flatlinerc/workshop_my-first-robot/GRABCAD/tt-dc-gear-motor-1.snapshot.3/Robot Car Gear Motor/Assembly.png

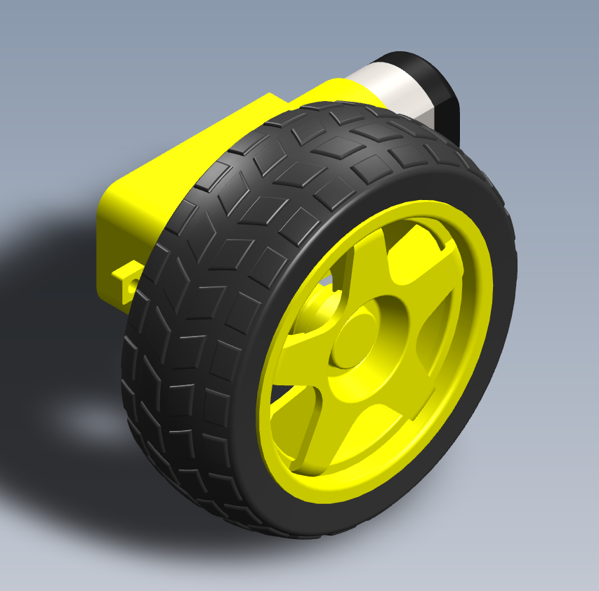
GRABCAD/tt-dc-gear-motor-1.snapshot.3/Robot Car Gear Motor/Assembly.png
