flatlinerc/workshop_my-first-robot/GRABCAD/module-vl53l0x-tof-distance-measurement-1.snapshot.7/vl53l0X_bottom_b.png

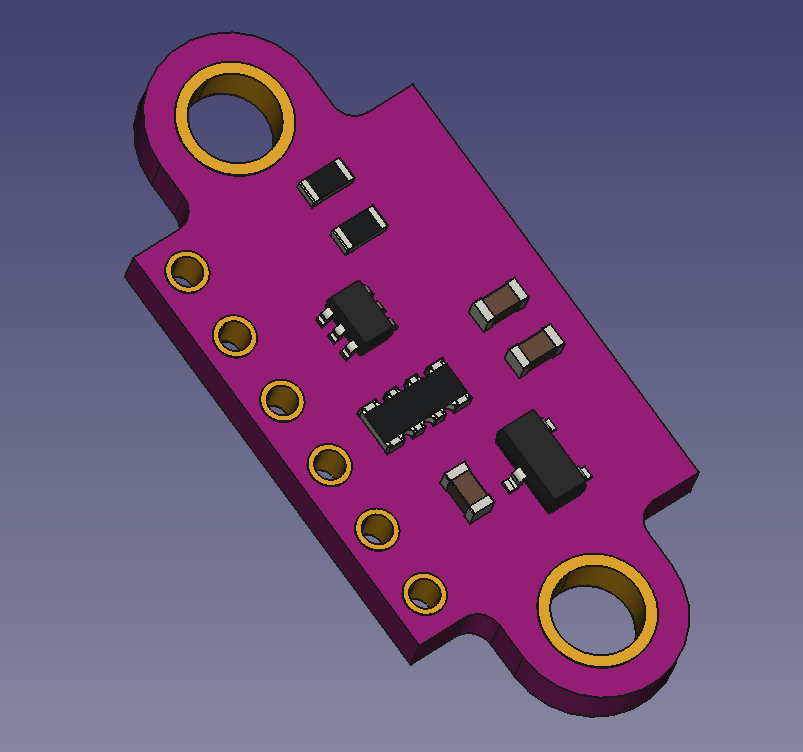
GRABCAD/module-vl53l0x-tof-distance-measurement-1.snapshot.7/vl53l0X_bottom_b.png
