flatlinerc/workshop_my-first-robot/README.md

# My First Robot

My First Robot is a workshop to give people an introduction into 'robotics'.  It consists of off the shelf parts, a 3d printed chassis, a software suite, teachers guide, and associated files.

This is designed to be expedient and made cheaply and quickly so that students can get an idea of how things can be done with 3d printers and the ready supply of hobbyist ready components.

BOM:

- ESP32 microcontroller
- VL53L0X ToF distance sensor
- DRV8833 dual motor driver breakout board
- 3d printed chassis
- M3 screws of varying sizes
- Dupont style jumper wires

# Links
- [ESP32 Pin Reference from FluidNC Wiki](http://wiki.fluidnc.com/en/hardware/esp32_pin_reference)
- [Fork of VL53L0X component](https://github.com/flatlinerc/ESP32_VL53L0X)
- [Firmware](https://github.com/flatlinerc/mfr-firmware)
- [CardCode](https://github.com/flatlinerc/cardcode)
