flatlinerc/workshop_my-first-robot/GRABCAD/ball-caster-1.snapshot.2/Renderings/Flange-Mount Ball Transfer.JPG

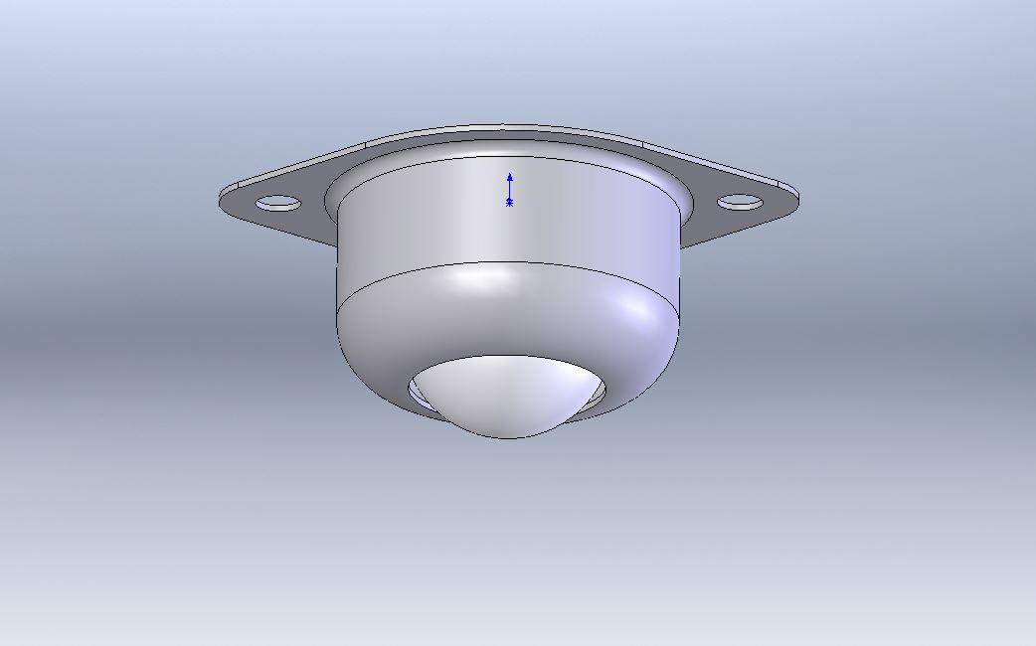
GRABCAD/ball-caster-1.snapshot.2/Renderings/Flange-Mount Ball Transfer.JPG
