flatlinerc/workshop_my-first-robot/GRABCAD/distance_sensor-1.snapshot.12/IMG/img_sensor1.JPG

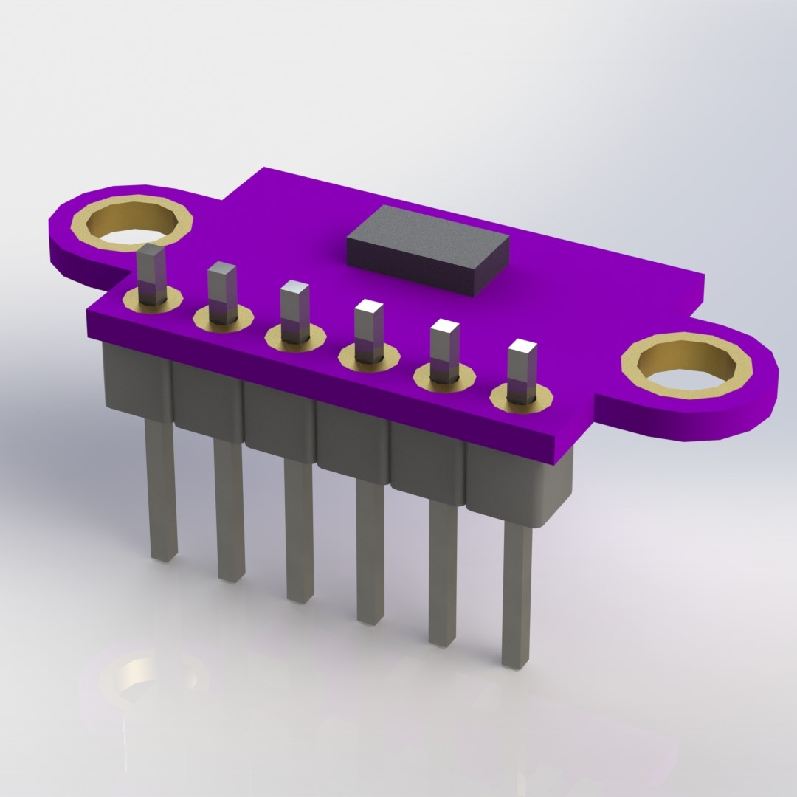
GRABCAD/distance_sensor-1.snapshot.12/IMG/img_sensor1.JPG
