flatlinerc/workshop_my-first-robot/GRABCAD/drv8833-carrier-breakout-board-1.snapshot.2/DRV8833.png

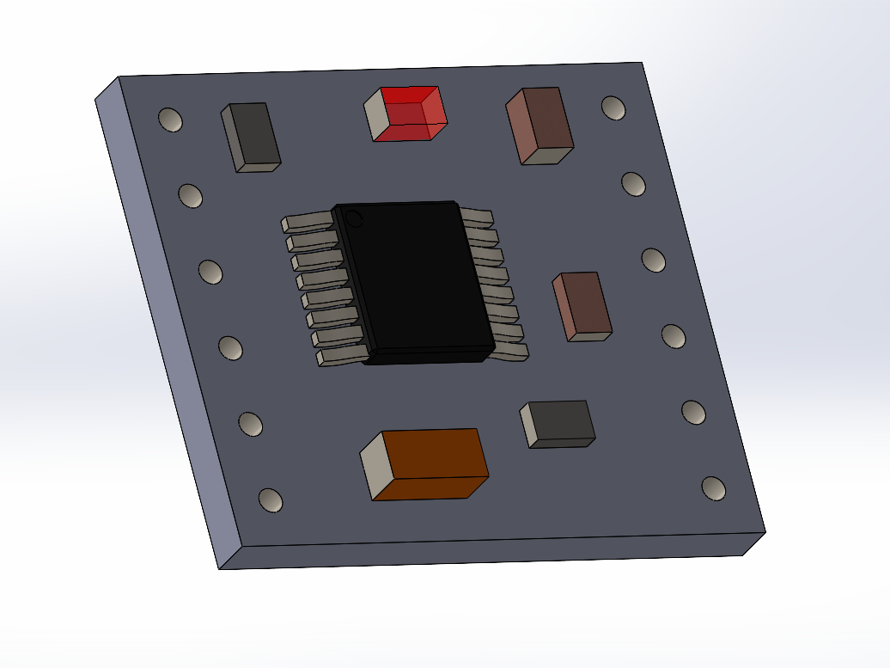
GRABCAD/drv8833-carrier-breakout-board-1.snapshot.2/DRV8833.png
