flatlinerc/workshop_my-first-robot/GRABCAD/drv8833-doble-puente-h-dual-h-bridge-motor-driver-1.snapshot.3/Modulo DRV8833/Renders/Modulo_DRV8833_A.jpg

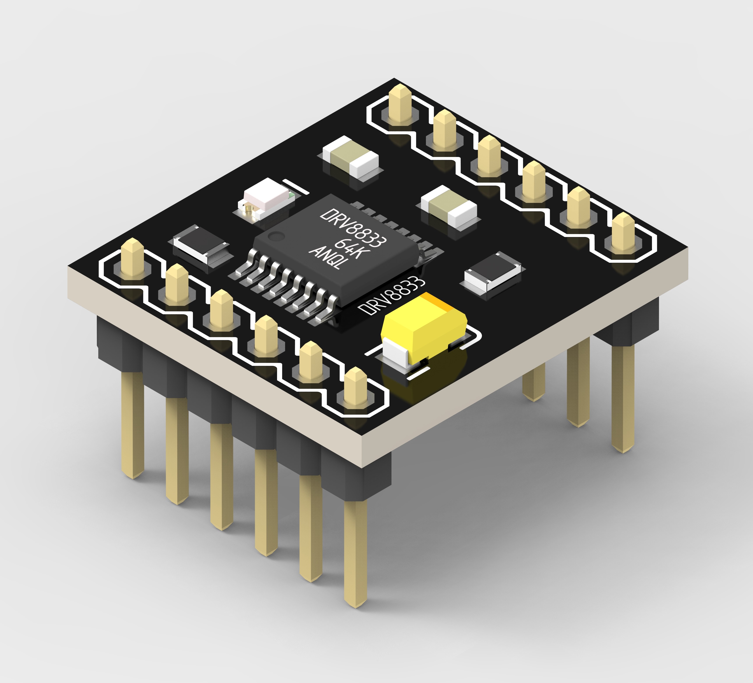
GRABCAD/drv8833-doble-puente-h-dual-h-bridge-motor-driver-1.snapshot.3/Modulo DRV8833/Renders/Modulo_DRV8833_A.jpg
