flatlinerc/workshop_my-first-robot/GRABCAD/drv8833-motor-driver-1.snapshot.2/DRV8833.JPG

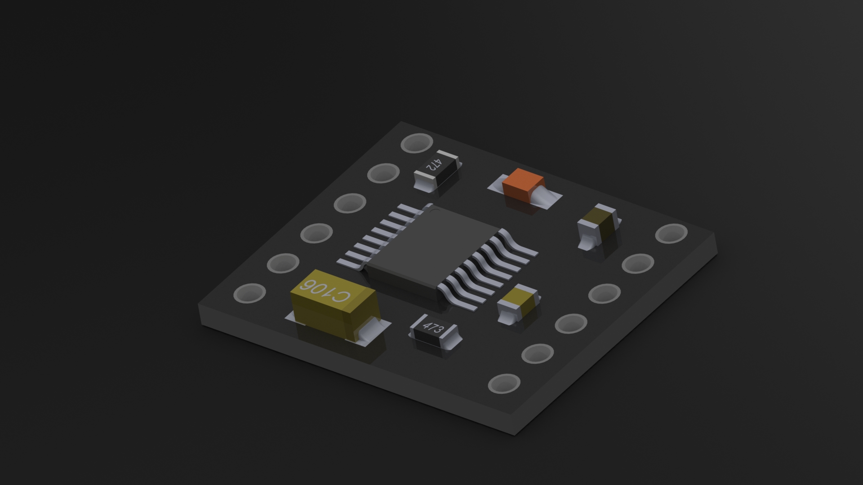
GRABCAD/drv8833-motor-driver-1.snapshot.2/DRV8833.JPG
