flatlinerc/workshop_my-first-robot/GRABCAD/esp32-dev-kit-v1-2.snapshot.2/34497376-0b36-4545-9b0b-ad642837c764.png

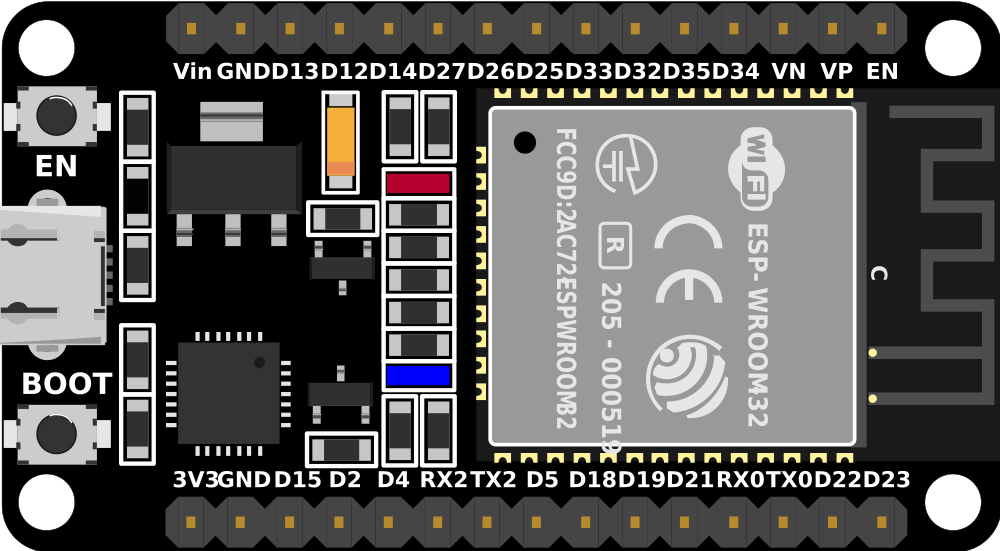
GRABCAD/esp32-dev-kit-v1-2.snapshot.2/34497376-0b36-4545-9b0b-ad642837c764.png
