flatlinerc/workshop_my-first-robot/GRABCAD/esp32-dev-kit-v1-2.snapshot.2/Capture d'écran 2026-04-18 234049.png

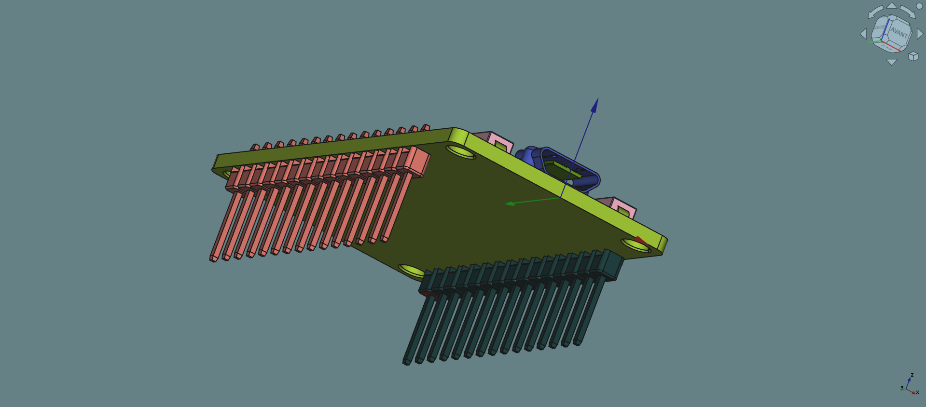
GRABCAD/esp32-dev-kit-v1-2.snapshot.2/Capture d'écran 2026-04-18 234049.png
