flatlinerc/workshop_my-first-robot/GRABCAD/esp_bot-1.snapshot.6/imagen_2026-02-18_211122814.png

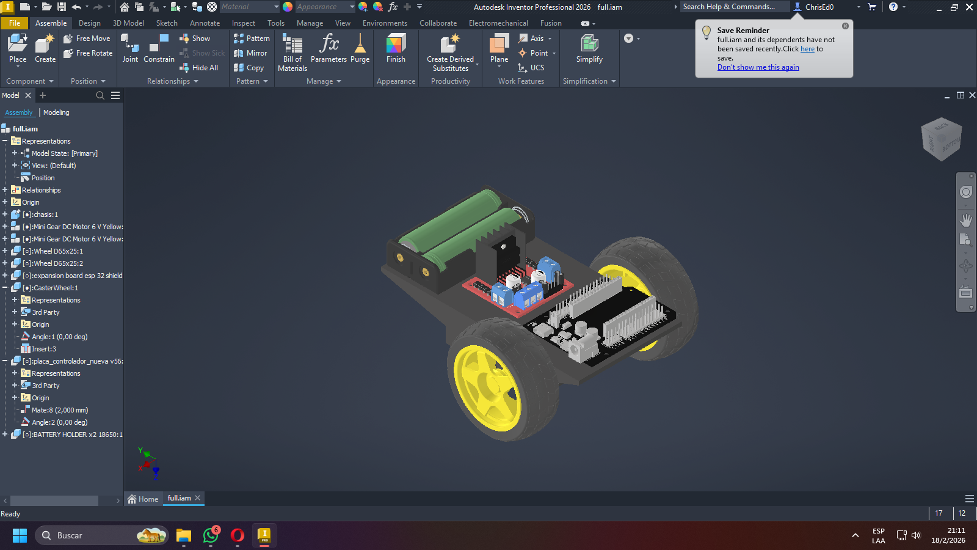
GRABCAD/esp_bot-1.snapshot.6/imagen_2026-02-18_211122814.png
