flatlinerc/workshop_my-first-robot/GRABCAD/vl53l0x-4.snapshot.11/VL53L0X dimensions.jpg

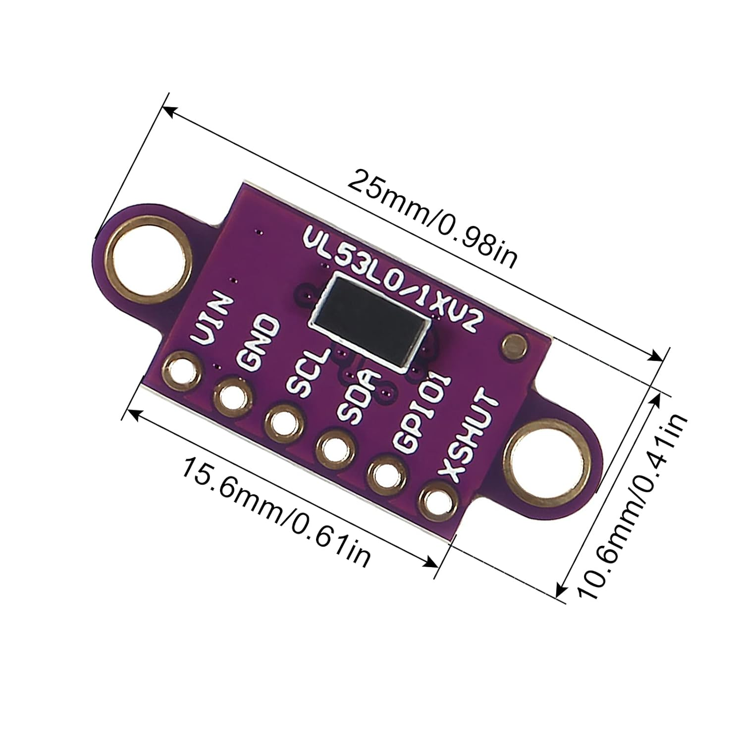
GRABCAD/vl53l0x-4.snapshot.11/VL53L0X dimensions.jpg
