flatlinerc/workshop_my-first-robot/GRABCAD/vl53l0x-laser-distance-sensor-1.snapshot.6/vl53l0x/view 1.JPG

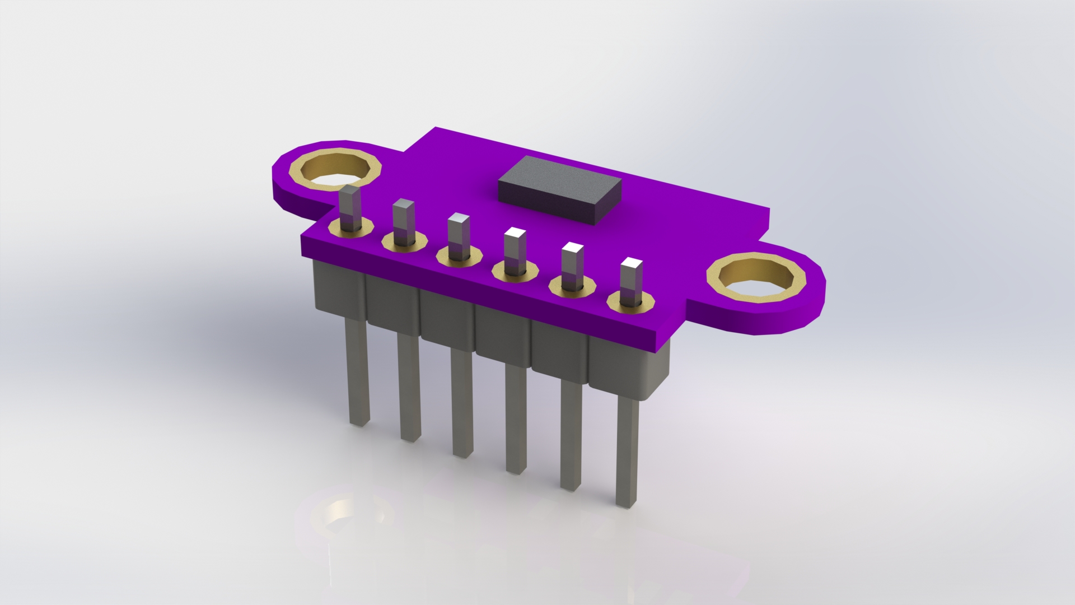
GRABCAD/vl53l0x-laser-distance-sensor-1.snapshot.6/vl53l0x/view 1.JPG
