flatlinerc/workshop_my-first-robot/GRABCAD/vl53l0x-tof-sensor-distancia-1.snapshot.3/VL53L0X_.jpg

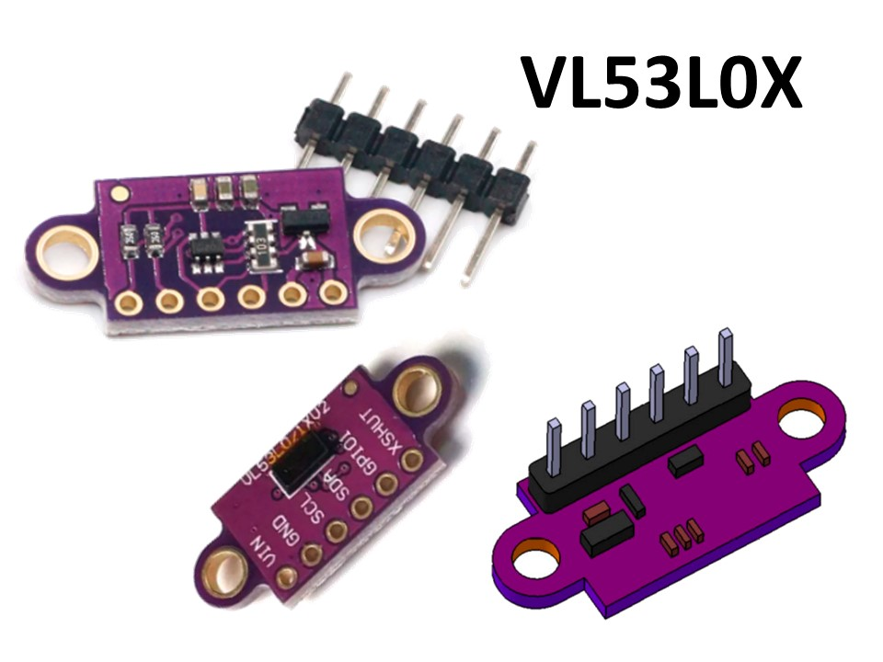
GRABCAD/vl53l0x-tof-sensor-distancia-1.snapshot.3/VL53L0X_.jpg
