flatlinerc/workshop_my-first-robot/CAD/MyFirstRobotAssem-v3-all-suppressed.SLDASM

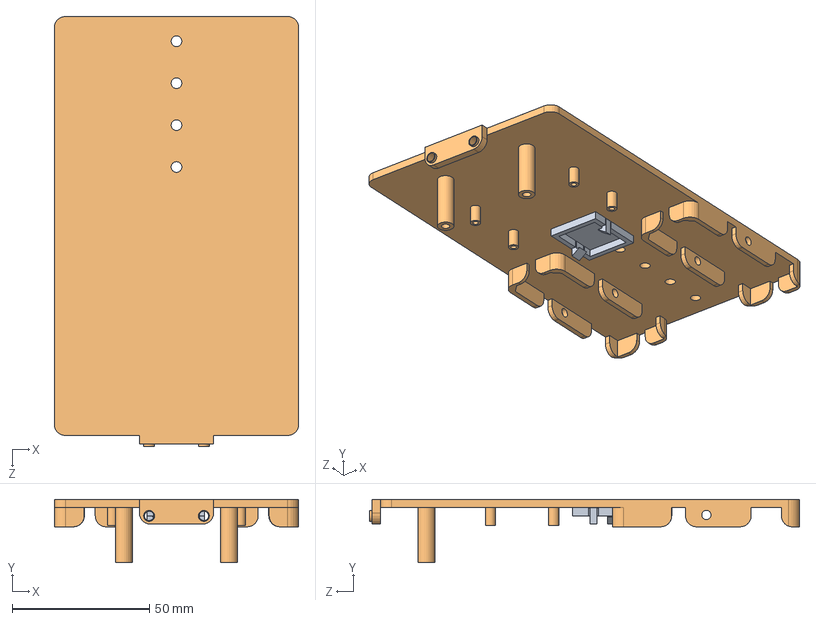
[picture p24: CAD file, 2026-07-23]
CAD/MyFirstRobotAssem-v3-all-suppressed.SLDASM
88.9 x 23.0 x 156.4 mm
MyFirstBotChassisV2
drv833-mount
