flatlinerc/workshop_my-first-robot/CAD/DriverMount.SLDASM

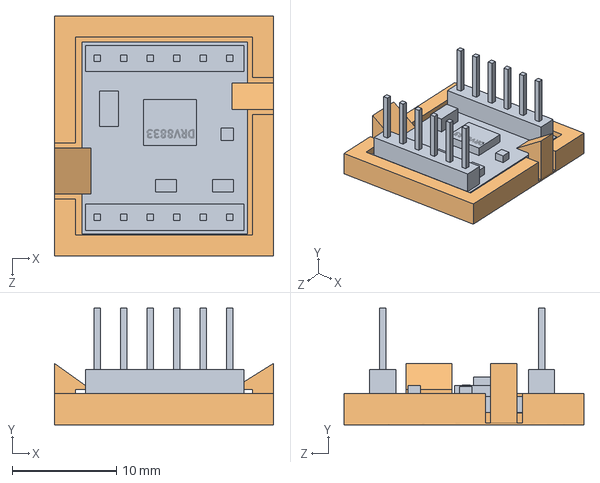
[picture p25: CAD file, 2026-06-06]
CAD/DriverMount.SLDASM
21.0 x 11.2 x 23.0 mm
drv833-mount
HBridgeDRV8833
