flatlinerc/workshop_my-first-robot/CAD/MyFirstBotChassisV2.SLDPRT

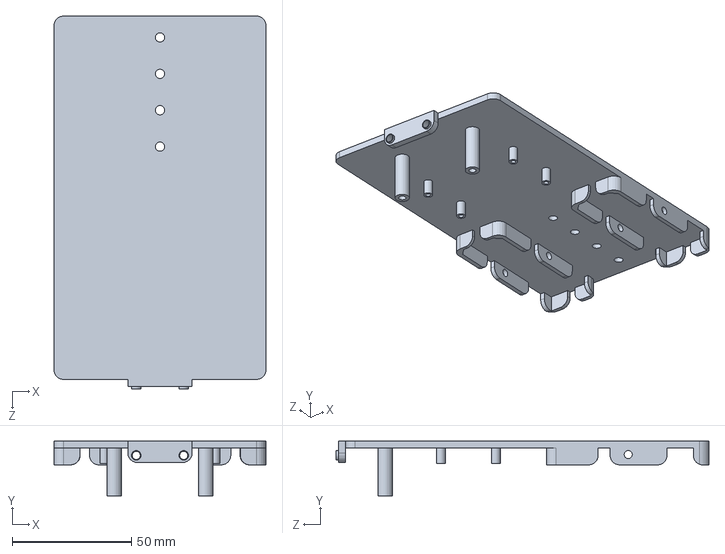
[picture p26: CAD file, 2026-07-23]
CAD/MyFirstBotChassisV2.SLDPRT
88.9 x 23.0 x 156.4 mm
