flatlinerc/workshop_my-first-robot/CAD/drv833-mount-v4.3MF

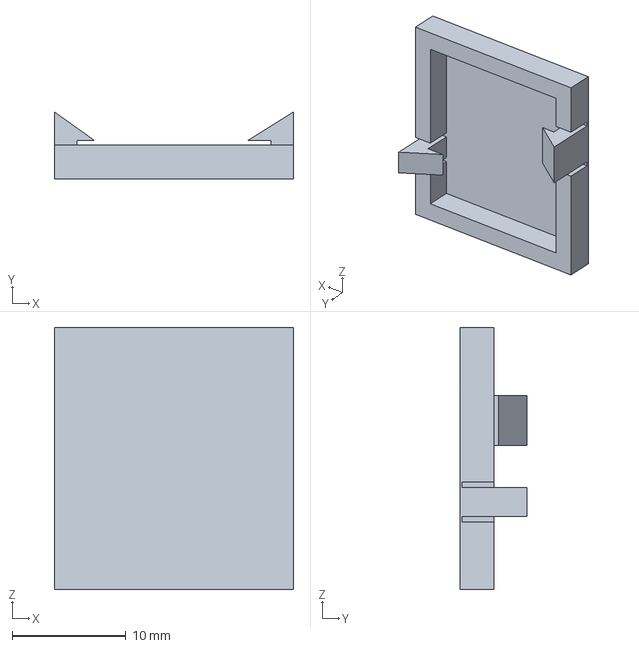
[picture p27: CAD file, 2026-06-06]
CAD/drv833-mount-v4.3MF
21.0 x 5.90 x 23.0 mm
