flatlinerc/workshop_my-first-robot/CAD/HBridgeDRV8833.SLDPRT

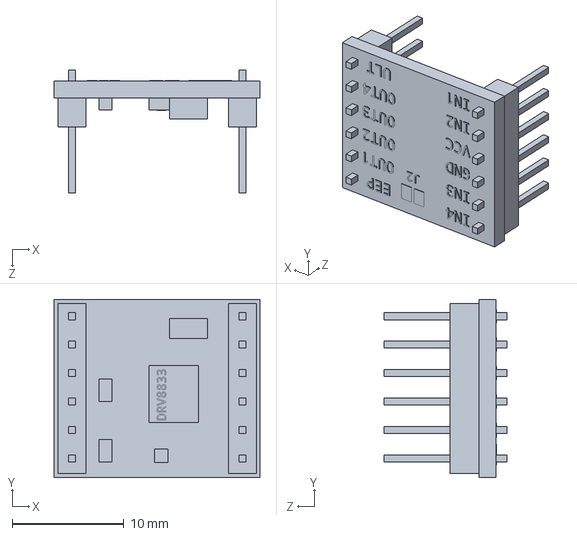
[picture p28: CAD file, 2026-06-06]
CAD/HBridgeDRV8833.SLDPRT
18.4 x 15.9 x 11.0 mm
