flatlinerc/workshop_my-first-robot/CAD/MyFirstRobotAssem-v3-Chassis.3MF

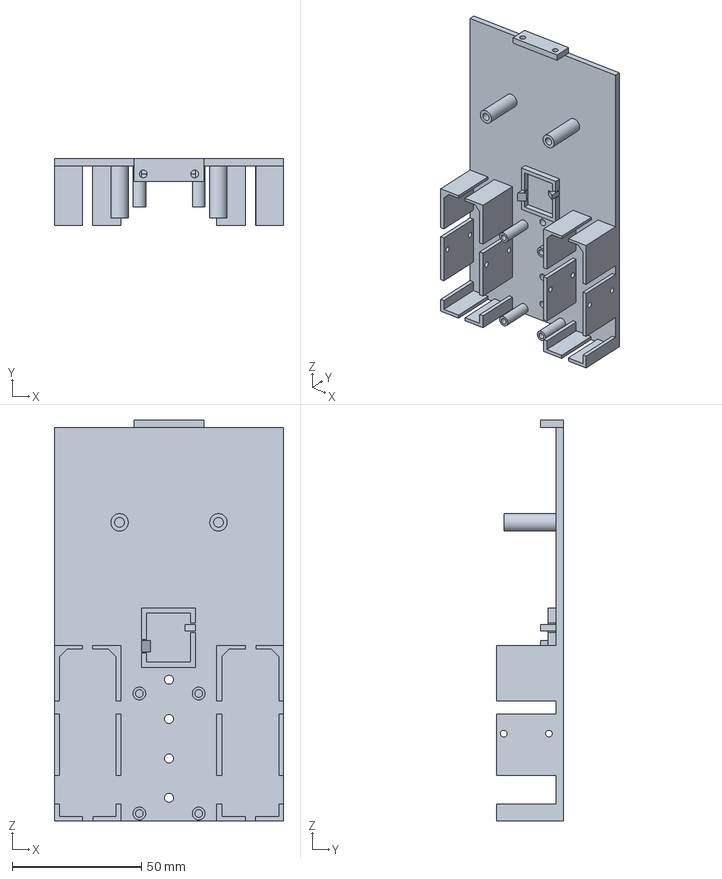
[picture p29: CAD file, 2026-06-06]
CAD/MyFirstRobotAssem-v3-Chassis.3MF
88.9 x 26.0 x 155.4 mm
