flatlinerc/workshop_my-first-robot/CAD/BatteryHolder.SLDPRT

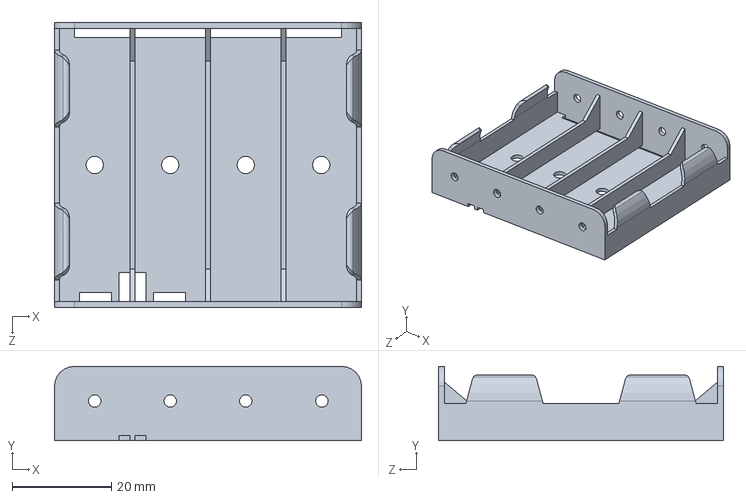
[picture p30: CAD file, 2026-06-06]
CAD/BatteryHolder.SLDPRT
62.0 x 15.0 x 57.5 mm
