flatlinerc/workshop_my-first-robot/CAD/MyFirstRobotAssem-v2.3MF

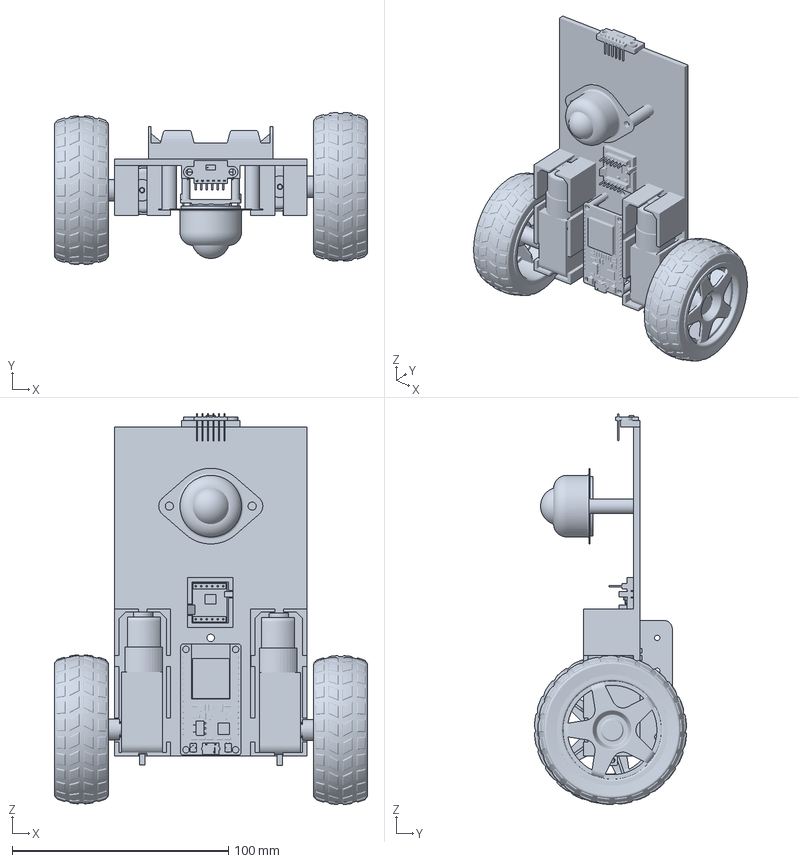
[picture p31: CAD file, 2026-06-06]
CAD/MyFirstRobotAssem-v2.3MF
144.9 x 70.4 x 181.0 mm
