flatlinerc/workshop_my-first-robot/CAD/MyFirstRobotChassis-V1.SLDPRT

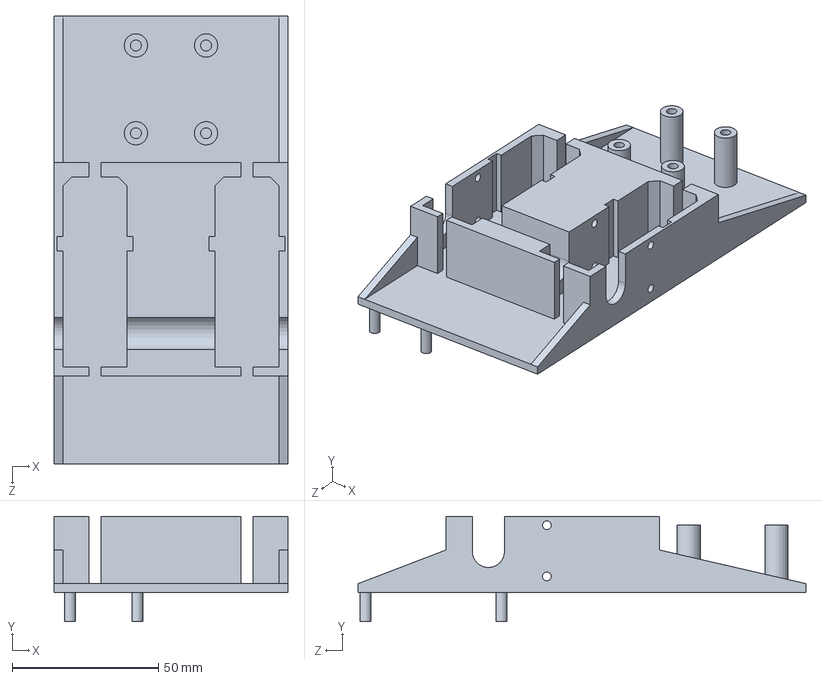
[picture p32: CAD file, 2026-06-06]
CAD/MyFirstRobotChassis-V1.SLDPRT
80.0 x 36.0 x 153.0 mm
