flatlinerc/workshop_my-first-robot/CAD/ESP32 dev Kit v1.SLDPRT

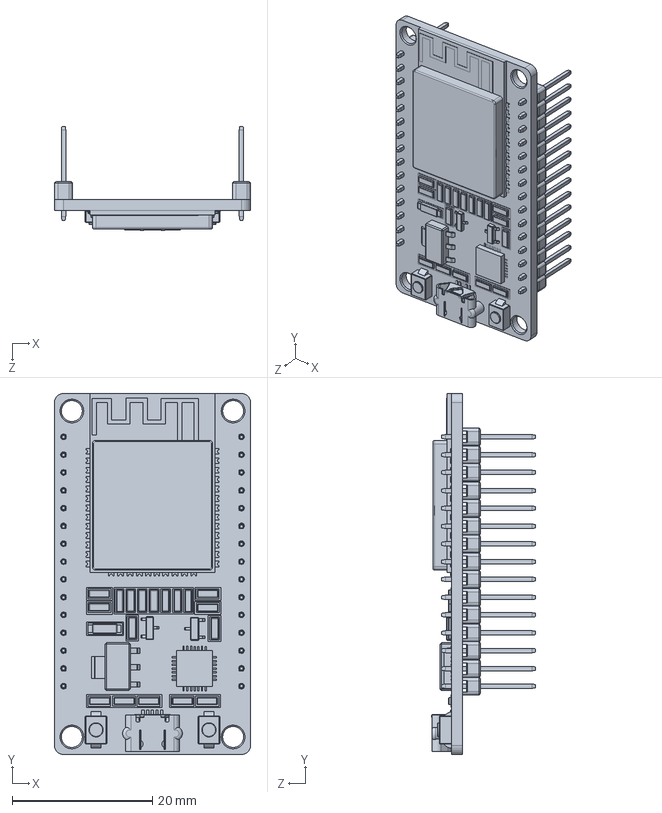
[picture p33: CAD file, 2026-06-06]
CAD/ESP32 dev Kit v1.SLDPRT
28.0 x 51.5 x 14.8 mm
