flatlinerc/workshop_my-first-robot/GRABCAD/ball-caster-1.snapshot.2/Flange-Mount Ball Transfer.SLDPRT

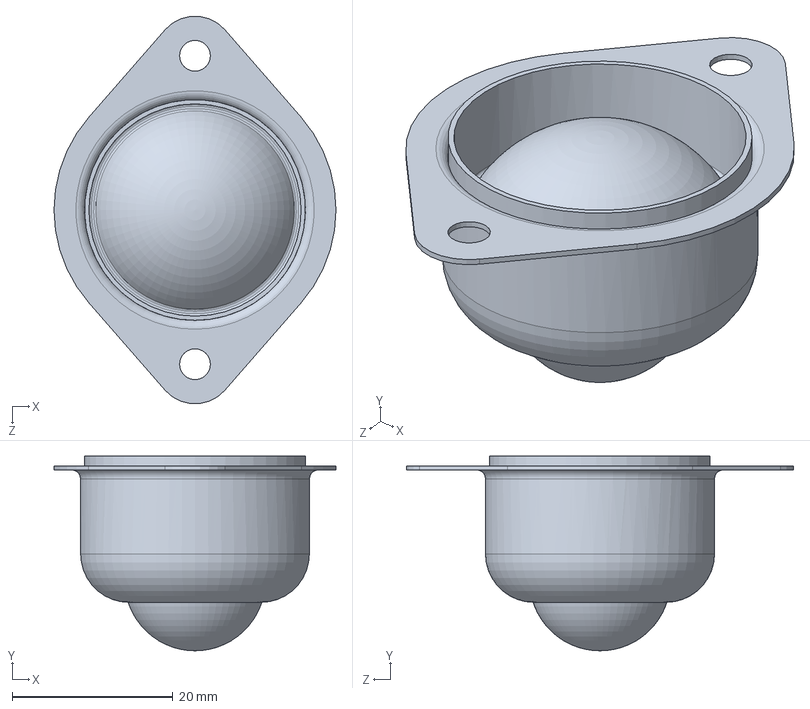
[picture p34: CAD file, 2026-07-08]
GRABCAD/ball-caster-1.snapshot.2/Flange-Mount Ball Transfer.SLDPRT
35.1 x 24.2 x 48.1 mm
