flatlinerc/workshop_my-first-robot/GRABCAD/drv8833-carrier-breakout-board-1.snapshot.2/DRV8833.STEP

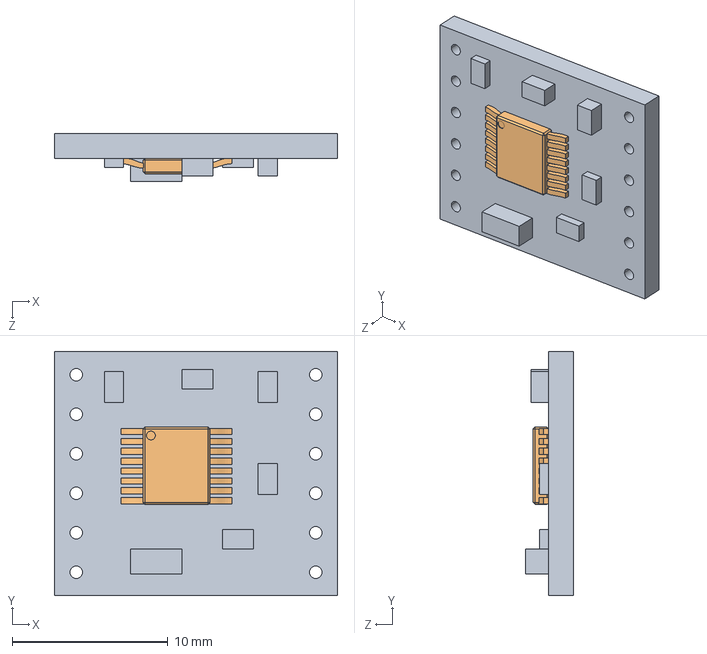
[picture p35: CAD file, 2026-07-08]
GRABCAD/drv8833-carrier-breakout-board-1.snapshot.2/DRV8833.STEP
18.2 x 15.7 x 3.10 mm
