flatlinerc/workshop_my-first-robot/GRABCAD/drv8833-doble-puente-h-dual-h-bridge-motor-driver-1.snapshot.3/Modulo DRV8833/Modulo_DRV8833_A.stp

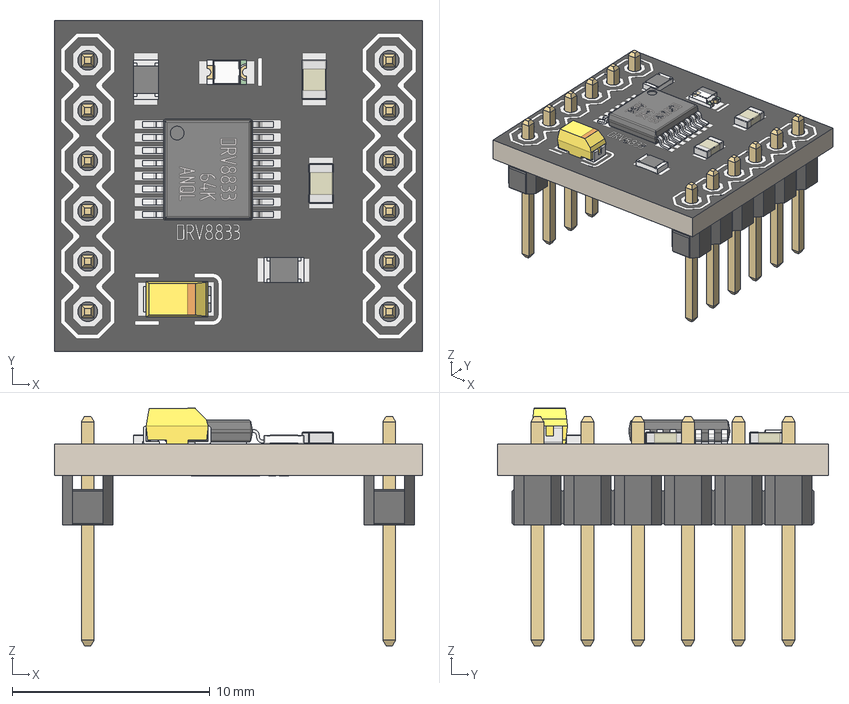
[picture p36: CAD file, 2026-07-08]
GRABCAD/drv8833-doble-puente-h-dual-h-bridge-motor-driver-1.snapshot.3/Modulo DRV8833/Modulo_DRV8833_A.stp
18.6 x 16.8 x 12.0 mm
placa
TSSOP_cuerpo_1.2h
TSSOP_pin_6.6 x 2
PIN_macho_1x6 x 2
T494A
C0805_060 x 2
R0805 x 2
housing
marking x 2
cover
base_2
base
