flatlinerc/workshop_my-first-robot/GRABCAD/tt-dc-gear-motor-1.snapshot.3/Robot Car Gear Motor/Gear Motor Assem.SLDASM

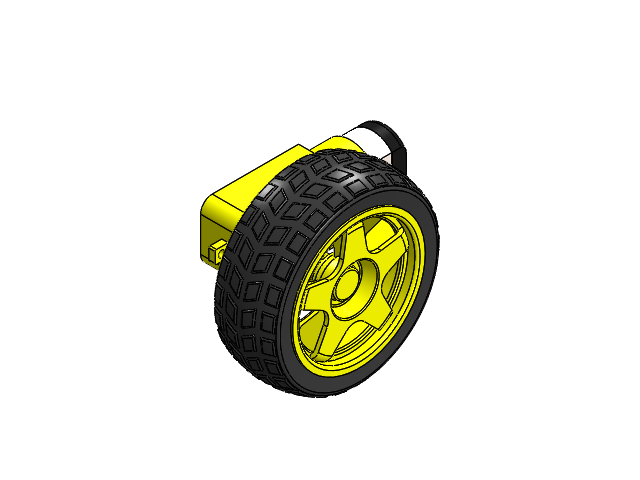
[picture p37: CAD file, 2026-07-08]
GRABCAD/tt-dc-gear-motor-1.snapshot.3/Robot Car Gear Motor/Gear Motor Assem.SLDASM
Gear Motor
Wheel
