flatlinerc/workshop_my-first-robot/GRABCAD/BATTERY_PACK/5`Ò 5`ý 5÷5` 4T.SLDASM

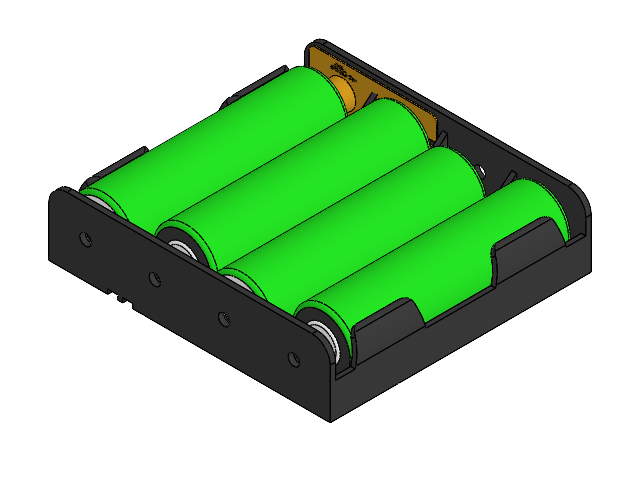
[picture p38: CAD file, 2026-07-08]
GRABCAD/BATTERY_PACK/5`Ò 5`ý 5÷5` 4T.SLDASM
电池盒4节5号
干电池 AA 5号电池 x 4
方形18650电池弹片-正负极for串联-5号电池
