flatlinerc/workshop_my-first-robot/(list of files, cad)

Other CAD files:
CAD/drv833-mount.SLDPRT
GRABCAD/distance_sensor-1.snapshot.12/STEP/sensor_assy.STEP
GRABCAD/BATTERY_PACK/µç³ØºÐ4½Ú5ºÅ.SLDPRT
CAD/MyFirstRobotAssem-v2-Chassis.3mf
CAD/drv833-mount.3MF
CAD/drv833-mount.v2.3MF
CAD/drv833-mount.v3.3MF
GRABCAD/BATTERY_PACK/·½ÐÎ18650µç³Øµ¯Æ¬-Õý¸º¼«for´®Áª-5ºÅµç³Ø.SLDPRT
GRABCAD/BATTERY_PACK/¸Éµç³Ø AA 5ºÅµç³Ø.SLDPRT
GRABCAD/distance_sensor-1.snapshot.12/SOLIDWORKS/headerPin.SLDPRT
GRABCAD/distance_sensor-1.snapshot.12/SOLIDWORKS/sensor.SLDPRT
GRABCAD/distance_sensor-1.snapshot.12/SOLIDWORKS/sensor_assy.SLDASM
GRABCAD/distance_sensor-1.snapshot.12/STEP/bracket.STEP
GRABCAD/distance_sensor-1.snapshot.12/STEP/headerPin.STEP
GRABCAD/distance_sensor-1.snapshot.12/STEP/sensor.STEP
GRABCAD/drv8833-carrier-breakout-board-1.snapshot.2/DRV8833.IGS
GRABCAD/drv8833-carrier-breakout-board-1.snapshot.2/DRV8833.SLDPRT
GRABCAD/drv8833-doble-puente-h-dual-h-bridge-motor-driver-1.snapshot.3/Modulo DRV8833/Modulo_DRV8833_B.stp
GRABCAD/drv8833-h-bridge-pcb-1.snapshot.1/HBridgeDRV8833.step
GRABCAD/drv8833-motor-driver-1.snapshot.2/DRV8833.STEP
GRABCAD/esp_bot-1.snapshot.6/BATTERY HOLDER x2 18650.stp
GRABCAD/esp_bot-1.snapshot.6/CasterWheel.stp
GRABCAD/esp_bot-1.snapshot.6/Mini Gear DC Motor 6 V Yellow.STEP
GRABCAD/esp_bot-1.snapshot.6/Wheel D65x25.ipt
GRABCAD/esp_bot-1.snapshot.6/placa_controlador_nueva v56.step
GRABCAD/tt-dc-gear-motor-1.snapshot.3/Robot Car Gear Motor/Gear Motor.SLDPRT
GRABCAD/tt-dc-gear-motor-1.snapshot.3/Robot Car Gear Motor/Gear Motor.STEP
GRABCAD/tt-dc-gear-motor-1.snapshot.3/Robot Car Gear Motor/Wheel.SLDPRT
GRABCAD/vl53l0x-4.snapshot.11/VL53L0X.f3d
GRABCAD/vl53l0x-4.snapshot.11/VL53L0X.step
GRABCAD/vl53l0x-laser-distance-sensor-1.snapshot.6/vl53l0x/pin_header.SLDPRT
GRABCAD/vl53l0x-laser-distance-sensor-1.snapshot.6/vl53l0x/vl53l0x no headers.STEP
GRABCAD/vl53l0x-laser-distance-sensor-1.snapshot.6/vl53l0x/vl53l0x.SLDASM
GRABCAD/vl53l0x-laser-distance-sensor-1.snapshot.6/vl53l0x/vl53l0x.STEP
GRABCAD/vl53l0x-laser-distance-sensor-1.snapshot.6/vl53l0x/vl53l0x_PCB.SLDPRT
GRABCAD/vl53l0x-tof-sensor-distancia-1.snapshot.3/VL53L0X TOF Sensor Distancia.stl
GRABCAD/vl53l0x-tof-sensor-distancia-1.snapshot.3/VL53L0X TOF Sensor Distancia.stp
GRABCAD/wheel-for-tt-gear-1.snapshot.1/Wheel D65x25.SLDPRT
