flatlinerc/workshop_my-first-robot/docs/My_First_Robot_Teachers_Guide.docx

MY FIRST ROBOT

A 2-Hour Hands-On Workshop

TEACHER'S GUIDE

## At a Glance

- Audience: Ages 12+, or curious adults. No prior coding or electronics experience required.
- Group size: Ideal 6–12 learners; one helper for every 4 students recommended.
- Duration: 2 hours, including one short stretch break.
- Cost per kit: Approximately $15–$25 USD depending on sourcing.
- Outcome: Each learner leaves with a working robot that drives forward and stops before hitting obstacles — and the confidence to modify the code.

## Learning Objectives

By the end of the workshop, each learner will be able to:

1. Name the three core jobs of any robot: sensing, thinking, and acting — and point to the part of their robot that does each one.
2. Wire a microcontroller, motor driver, and I²C sensor safely, with attention to common ground and voltage levels.
3. Upload code to an ESP32 using the Arduino IDE and modify simple parameters (motor speed, distance threshold).
4. Diagnose at least one problem (a wheel spinning backward, a sensor not detected, a robot drifting) using the troubleshooting table.
5. Describe one realistic next step for extending their robot (a buzzer, a second sensor, remote control, line following).

# Before the Workshop

## Two Weeks Out

- Order all kit parts — yellow gear motors and VL53L0X modules can have long shipping times. Order 20% extras for failures.
- Pre-flash a known-good copy of the sketch onto one ESP32 to use as the demo robot.
- Print the student handout and the take-home extension sheet (one per learner).

## The Day Before

- Charge or buy fresh AA batteries. Alkaline is fine; NiMH gives more cycles but lower voltage.
- Bag each kit individually with a printed checklist on the front. Tape the checklist to the bag.
- Test one full kit end-to-end yourself. If anything fails, you have time to fix it.
- Pre-install the Arduino IDE, the ESP32 board package, and the Adafruit_VL53L0X library on all loaner laptops. Pre-select the board (DOIT ESP32 DEVKIT V1) so students only have to pick the COM port.

## 30 Minutes Before

- Set out kits, screwdrivers, and laptops at each station.
- Tape an obstacle course on the floor: a simple zigzag of books or cardboard works.
- Have the demo robot rolling around when learners walk in — it sets the tone.

# Bill of Materials

Per student kit. The whole kit fits in a sandwich-sized zip bag.

Component | Qty / Student | Purpose
ESP32 DevKit V1 | 1 | Microcontroller — the brain. Runs the code, talks to the sensor, drives the motors.
DRV8833 dual H-bridge motor driver | 1 | Converts logic-level signals from the ESP32 into the higher currents the motors need; allows forward/reverse.
Yellow TT gear motor with wheel | 2 | Differential drive — spin both forward to go straight, one forward + one reverse to spin in place.
VL53L0X Time-of-Flight sensor module | 1 | Tiny laser that measures distance up to ~1.2 m. Communicates over I²C.
4×AA battery holder (no switch) | 1 | Powers the motors directly (≈6 V); also feeds ESP32 via VIN. No switch — inserting the batteries powers the robot.
AA batteries (alkaline or NiMH) | 4 | Power source.
Robot chassis or laser-cut base | 1 | Anything flat with motor mounts; a piece of corrugated plastic and zip-ties works fine.
Caster wheel or marble ball-bearing | 1 | The third point of contact behind the two driven wheels.
Male-female & female-female jumper wires | ~12 | For sensor and driver connections.
Micro-USB cable (data, not charge-only) | 1 | To flash code to the ESP32.
Small Phillips screwdriver | 1 | Mounting motors and battery pack.
2.5mm Allen wrench | 1 | For the socket-head screws used during assembly.
WAGO splice connectors | 2 | Share Battery + and ground between the battery pack, DRV8833, and ESP32.
Screw kit: 2× small M3 + 2× longer M3 hex socket head cap screws, 4× M3 nuts, 4× #2-28 pan head Phillips thread rolling, 2× M3.5 flat head Phillips + 2× M3.5 nuts, 2× #6 pan head Phillips thread rolling | — | Small M3s: lidar. Longer M3s: motors. #2-28: ESP32 mount. M3.5: battery pack. #6: caster. No tape or glue.

# Wiring Reference

Hand this to each student or display it on a screen. The DRV8833 sits between the ESP32 and the motors; nothing else connects to the motors directly. Point out that on this microcontroller, an ESP32 DevKit V1, the D numbers printed on the board match the GPIO numbers — but this is not always the case, so students should get in the habit of checking the pinouts and datasheets of all their components.

From | To (ESP32 pin) | Notes
DRV8833 AIN1 | GPIO 14 | Left motor direction A
DRV8833 AIN2 | GPIO 27 | Left motor direction B
DRV8833 BIN1 | GPIO 26 | Right motor direction A
DRV8833 BIN2 | GPIO 25 | Right motor direction B
DRV8833 AOUT1/2 | Left motor | Polarity doesn't matter — swap in code if it spins the wrong way
DRV8833 BOUT1/2 | Right motor | Same — swap if needed
DRV8833 VM | Battery + | Motor power, ≈6 V from 4×AA — shared through the Battery + WAGO splice
DRV8833 GND | ESP32 GND + Battery − | All grounds meet in the ground WAGO splice — common ground is essential
VL53L0X VCC | 3V3 | Do NOT use 5V — the sensor is 3.3V logic
VL53L0X GND | GND
VL53L0X SDA | GPIO 21 | I²C data
VL53L0X SCL | GPIO 22 | I²C clock
ESP32 VIN | Battery + (optional) | From the same Battery + WAGO splice — powers the ESP32 from the AA pack, only after wiring is checked

### Safety Checks Before Powering On

- Common ground? ESP32 GND, DRV8833 GND, and Battery − should all connect.
- VL53L0X on 3.3 V, not 5 V. (Many other I²C sensors tolerate 5 V; this one prefers 3.3 V.)
- No bare motor wires touching each other or the chassis.
- Batteries stay OUT of the holder until a helper has eyeballed the wiring — with no switch, the batteries are the switch.

# Minute-by-Minute Schedule

Times are guidelines. The build pace varies a lot by group; build in a 10-minute buffer by trimming the show-and-reflect if needed.

Time | Segment | Activities & Talking Points | Materials
0:00–0:10 | Welcome & The Big Idea | Greet learners. Show a finished robot rolling around and stopping at a wall. Ask: "How did it know the wall was there?" Introduce the three jobs of any robot: SENSE → THINK → ACT. Distribute kits and inventory parts together. | Finished demo robot; kit per student
0:10–0:25 | Meet the Parts | Hold up each part and pass one around. ESP32 = the brain. DRV8833 = the muscles. Yellow gear motors = the wheels. VL53L0X = the eye (a tiny laser tape measure). 4×AA pack = the heart. Briefly explain why we need a motor driver (the ESP32 pins are too weak to spin motors). | One of each part for show-and-tell
0:25–0:50 | Build: Chassis & Motors | Mount motors to chassis with the longer M3 socket head screws and nuts — leave the wheels OFF for now; they get in the way. Bolt the VL53L0X to the front with the small M3 socket head screws and nuts. Insert the DRV8833 into its slot; screw the ESP32 into position with the #2-28 pan head thread rolling screws. Wire motor leads to DRV8833 outputs (AOUT1/2, BOUT1/2). Emphasize: red & black don't matter yet — we'll fix direction in code. Bolt battery pack on top with the M3.5 flat head screws and nuts. | Chassis, screwdrivers, Allen wrenches, screws & nuts
0:30 BREAK | Stretch (2 min) | Quick stretch break partway through the build. Check that no one is stuck. | —
0:50–1:10 | Build: Wiring the Brain | Connect DRV8833 to ESP32 (IN1–IN4 to GPIO 14, 27, 26, 25). Connect VL53L0X with 4 wires: VCC→3V3, GND→GND, SDA→GPIO 21, SCL→GPIO 22. Battery + and ground are shared via WAGO splices: one splice for Battery + (DRV8833 VM + ESP32 VIN), one for all grounds. Once the VL53L0X is wired, attach the caster with the #6 pan head thread rolling screws, then press the wheels on — wheels go LAST because they get in the way during wiring. DO NOT power yet. Teacher walks each table to check wiring before any battery goes in. | Jumper wires, the kits
1:10–1:35 | Code: Make It Move | Open pre-loaded Arduino sketch. Confirm each laptop shows Board = DOIT ESP32 DEVKIT V1 and the right COM port (unplug/replug the USB cable to spot it) before anyone clicks Upload. Walk through analogWrite() for motor PWM. Students upload, place robot on floor, and trim direction (swap motor leads if a wheel spins backward). Celebrate first movement! | Laptops, micro-USB cables
1:35–1:55 | Code: Make It See | Add the VL53L0X library calls. Read distance in mm. Add the rule: IF distance < 200 mm THEN stop and turn. Upload, test, tune the threshold. This is the magic moment — the robot reacts to the world. | Same setup
1:55–2:00 | Show & Reflect | Mini parade: each robot drives a short obstacle course. Ask: "What would you add next — a buzzer? A second sensor? A line follower?" Send students home with the take-home sheet. | Tape obstacle course on floor; handout

# Teaching Notes & Talking Points

## The Big Idea: Sense → Think → Act

Every robot — from a Roomba to a Mars rover — does the same three things. The ESP32 thinks. The VL53L0X senses. The motors act. Keep returning to this framing; it is the single most important takeaway.

## Why a Motor Driver?

Beginners often ask: why can't the ESP32 just spin the motor directly? Two reasons. First, an ESP32 GPIO pin can supply about 20–40 mA, but a gear motor wants 200+ mA at startup. Second, to make a motor spin backward the current has to flow through it in the opposite direction — the polarity is reversed, like putting a battery in backwards. An H-bridge (which is what the DRV8833 contains) flips that polarity in software. Show the chip and trace the path with your finger: brain → muscles → wheels.

## Why I²C?

The VL53L0X talks to the ESP32 with only two wires (plus power and ground) — SDA (data) and SCL (clock). This is I²C. You don't need to teach the protocol; just point out that it's a shared bus, so future students can add more sensors on the same two wires. That's the seed of an extension project.

## Distances in Millimeters

The VL53L0X returns distance in millimeters. Students often forget this and set the threshold to "20" expecting 20 cm — the robot then thinks the wall is always far away. Have them print the live reading to Serial Monitor before tuning the threshold. A good starting value is 200 mm (20 cm).

## Differential Drive

Two independently-controlled wheels and a passive caster create a "differential drive" robot. Both forward: go straight. One forward, one reverse: spin in place. One forward, one stopped: gentle curve. Most students discover this by accident — invite them to swap motor speeds and see what happens.

## Common Misconception: "My code is wrong"

When the robot misbehaves, students almost always assume the code is broken. About 80% of the time it's wiring (loose jumper, swapped pins, battery dead). Train them to check power and continuity first, then code. The troubleshooting table in this guide is built around that order.

# Troubleshooting

Most issues are wiring or power. Work down this list before opening the code.

Symptom | Likely Cause & Fix
Robot does nothing | Check batteries are inserted (there is no switch) and oriented correctly, the WAGO splices grip each wire (tug test), and the DRV8833 VM and GND are wired. Verify the sketch actually uploaded (look for "Done uploading" in Arduino IDE).
One wheel spins backward | Swap the two motor leads at the DRV8833 output, OR swap the two GPIOs in code (e.g., flip IN1/IN2).
Both wheels backward | Reverse the driver output wires (swap each motor's leads at the DRV8833 outputs) — or reverse the output in the code.
Robot drifts left or right | Yellow gear motors aren't perfectly matched. Reduce PWM on the faster side by 10–20 (e.g., 200 vs 220).
Distance reading is 8190 or always 0 | VL53L0X not detected. Check SDA/SCL not swapped, sensor on 3.3 V (not 5 V), and the library begin() returns true.
ESP32 keeps rebooting under load | Brownout — batteries are low, or the ESP32 is being powered from USB while motors draw current. Use fresh AAs and disconnect USB during driving tests.
Upload fails: "Failed to connect" | Hold the BOOT button while clicking Upload, release when "Connecting..." appears. Confirm the cable is a data cable, not charge-only.
Sensor reads correctly but robot doesn't stop | Threshold mismatch — print the distance to Serial and confirm units (mm). 200 mm = 20 cm.

# Starter Sketch (Reference)

Pre-load this on a USB stick or on the loaner laptops. Walk through it line by line during the coding segment — do not have students type it from scratch in a 2-hour workshop.

#include <Wire.h>

#include <Adafruit_VL53L0X.h>

// Motor pins (DRV8833)

const int AIN1 = 14, AIN2 = 27; // left motor

const int BIN1 = 26, BIN2 = 25; // right motor

Adafruit_VL53L0X lox;

void drive(int left, int right) {

// values from -255 to +255

analogWrite(AIN1, left > 0 ? left : 0);

analogWrite(AIN2, left < 0 ? -left : 0);

analogWrite(BIN1, right > 0 ? right : 0);

analogWrite(BIN2, right < 0 ? -right : 0);

}

void setup() {

Serial.begin(115200);

pinMode(AIN1, OUTPUT); pinMode(AIN2, OUTPUT);

pinMode(BIN1, OUTPUT); pinMode(BIN2, OUTPUT);

if (!lox.begin()) { Serial.println("Sensor not found"); while (1); }

}

void loop() {

VL53L0X_RangingMeasurementData_t m;

lox.rangingTest(&m, false);

int d = (m.RangeStatus != 4) ? m.RangeMilliMeter : 9999;

Serial.println(d);

if (d > 200) {

drive(200, 200); // forward

} else {

drive(180, -180); // spin to find a clear path

delay(400);

}

}

# Extensions for Fast Finishers

Have these ready for the one or two students who finish 20 minutes early. They keep the room calm and give advanced learners a stretch goal.

### Easy (5–10 minutes)

- Tune the threshold and the turn time. How close can the robot get before it stops?
- Change the spin direction — does the robot prefer to turn left or right?
- Make the robot drive slower or faster by changing the PWM values.

### Medium (10–20 minutes)

- Add a piezo buzzer on a spare GPIO — beep when an obstacle is close.
- Add an LED that brightens as the robot gets closer to a wall (map distance → analogWrite).
- Make the spin time proportional to distance — short obstacle, short turn; close obstacle, long turn.

### Advanced (20+ minutes, or a follow-up session)

- Add a second VL53L0X. The two sensors share the I²C bus but need different addresses — use the XSHUT pin to bring them up one at a time.
- Add Wi-Fi control: drive the robot from a web page served by the ESP32 itself.
- Log distance readings to Serial and plot them in the Arduino IDE Serial Plotter — you've just built a turtle that draws a map.

# Quick Informal Assessment

In the final 5 minutes, ask each student one of these questions. There is no grade — just a chance to surface understanding.

6. Point to the part of your robot that senses. Now the part that thinks. Now the part that acts.
7. Why can't the ESP32 spin the motor directly?
8. Your robot is driving backward. What's the fastest way to fix it — code or wiring? (Either is fine.)
9. If you had one more sensor, what would it be? What would the robot do with it?

# Safety & Classroom Management

- Eyes: warn against staring directly into the VL53L0X. It is a Class 1 laser (eye-safe under normal conditions) but the etiquette is good practice for future projects with stronger lasers.
- Batteries: alkaline AAs are very safe, but a short circuit will still heat up wires. Have a helper inspect every kit before the batteries go in.
- Small parts: screws and jumpers roll. A small parts tray per table prevents 80% of "I lost a screw" moments.
- Driving area: clear a 2 × 2 m space on the floor. Robots will collide; that's fine. Keep bags and laptop cables out of the runway.
- Pace: if a student is behind, pair them with a finished student rather than rushing them. Everyone leaves with a working robot.

MY FIRST ROBOT Teacher's Guide
