flatlinerc/workshop_my-first-robot/GRABCAD/module-vl53l0x-tof-distance-measurement-1.snapshot.7/VL53L0X_TOF_top.png

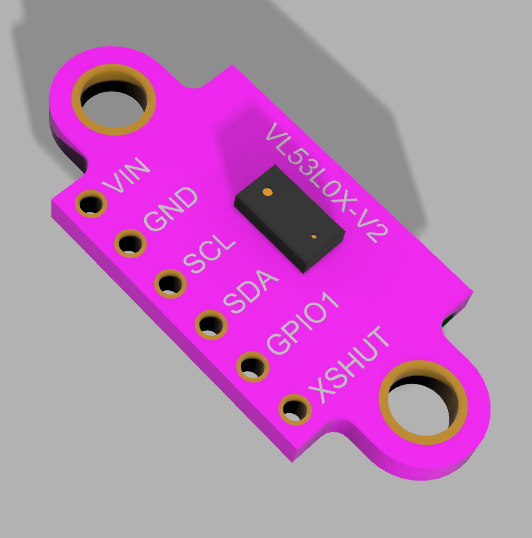
GRABCAD/module-vl53l0x-tof-distance-measurement-1.snapshot.7/VL53L0X_TOF_top.png
