flatlinerc/workshop_my-first-robot/(commit log)

2026-06-06 CAD files
    [BatteryHolder.SLDPRT, DriverMount.SLDASM, ESP32 dev Kit v1.SLDPRT, HBridgeDRV8833.SLDPRT, MyFirstBotChassisV2.SLDPRT, MyFirstRobotAssem-v2-Chassis.3mf, MyFirstRobotAssem-v2.3MF, MyFirstRobotAssem-v3-Chassis.3MF]
2026-07-08 CAD and moar
    [5`Ò 5`ý 5÷5` 4T.SLDASM, BATTERY HOLDER x2 18650.stp, CasterWheel.stp, DRV8833.IGS, DRV8833.SLDPRT, DRV8833.STEP, Flange-Mount Ball Transfer.SLDPRT, Gear Motor Assem.SLDASM]
2026-07-23 add back chassis sld
    [MyFirstBotChassisV2.SLDPRT]
